TheLexoPlexx/espio/pcb/v2_6/espio.kicad_pcb

## KiCad design pcb/v2_6/espio.kicad_pcb (2025-10-19)

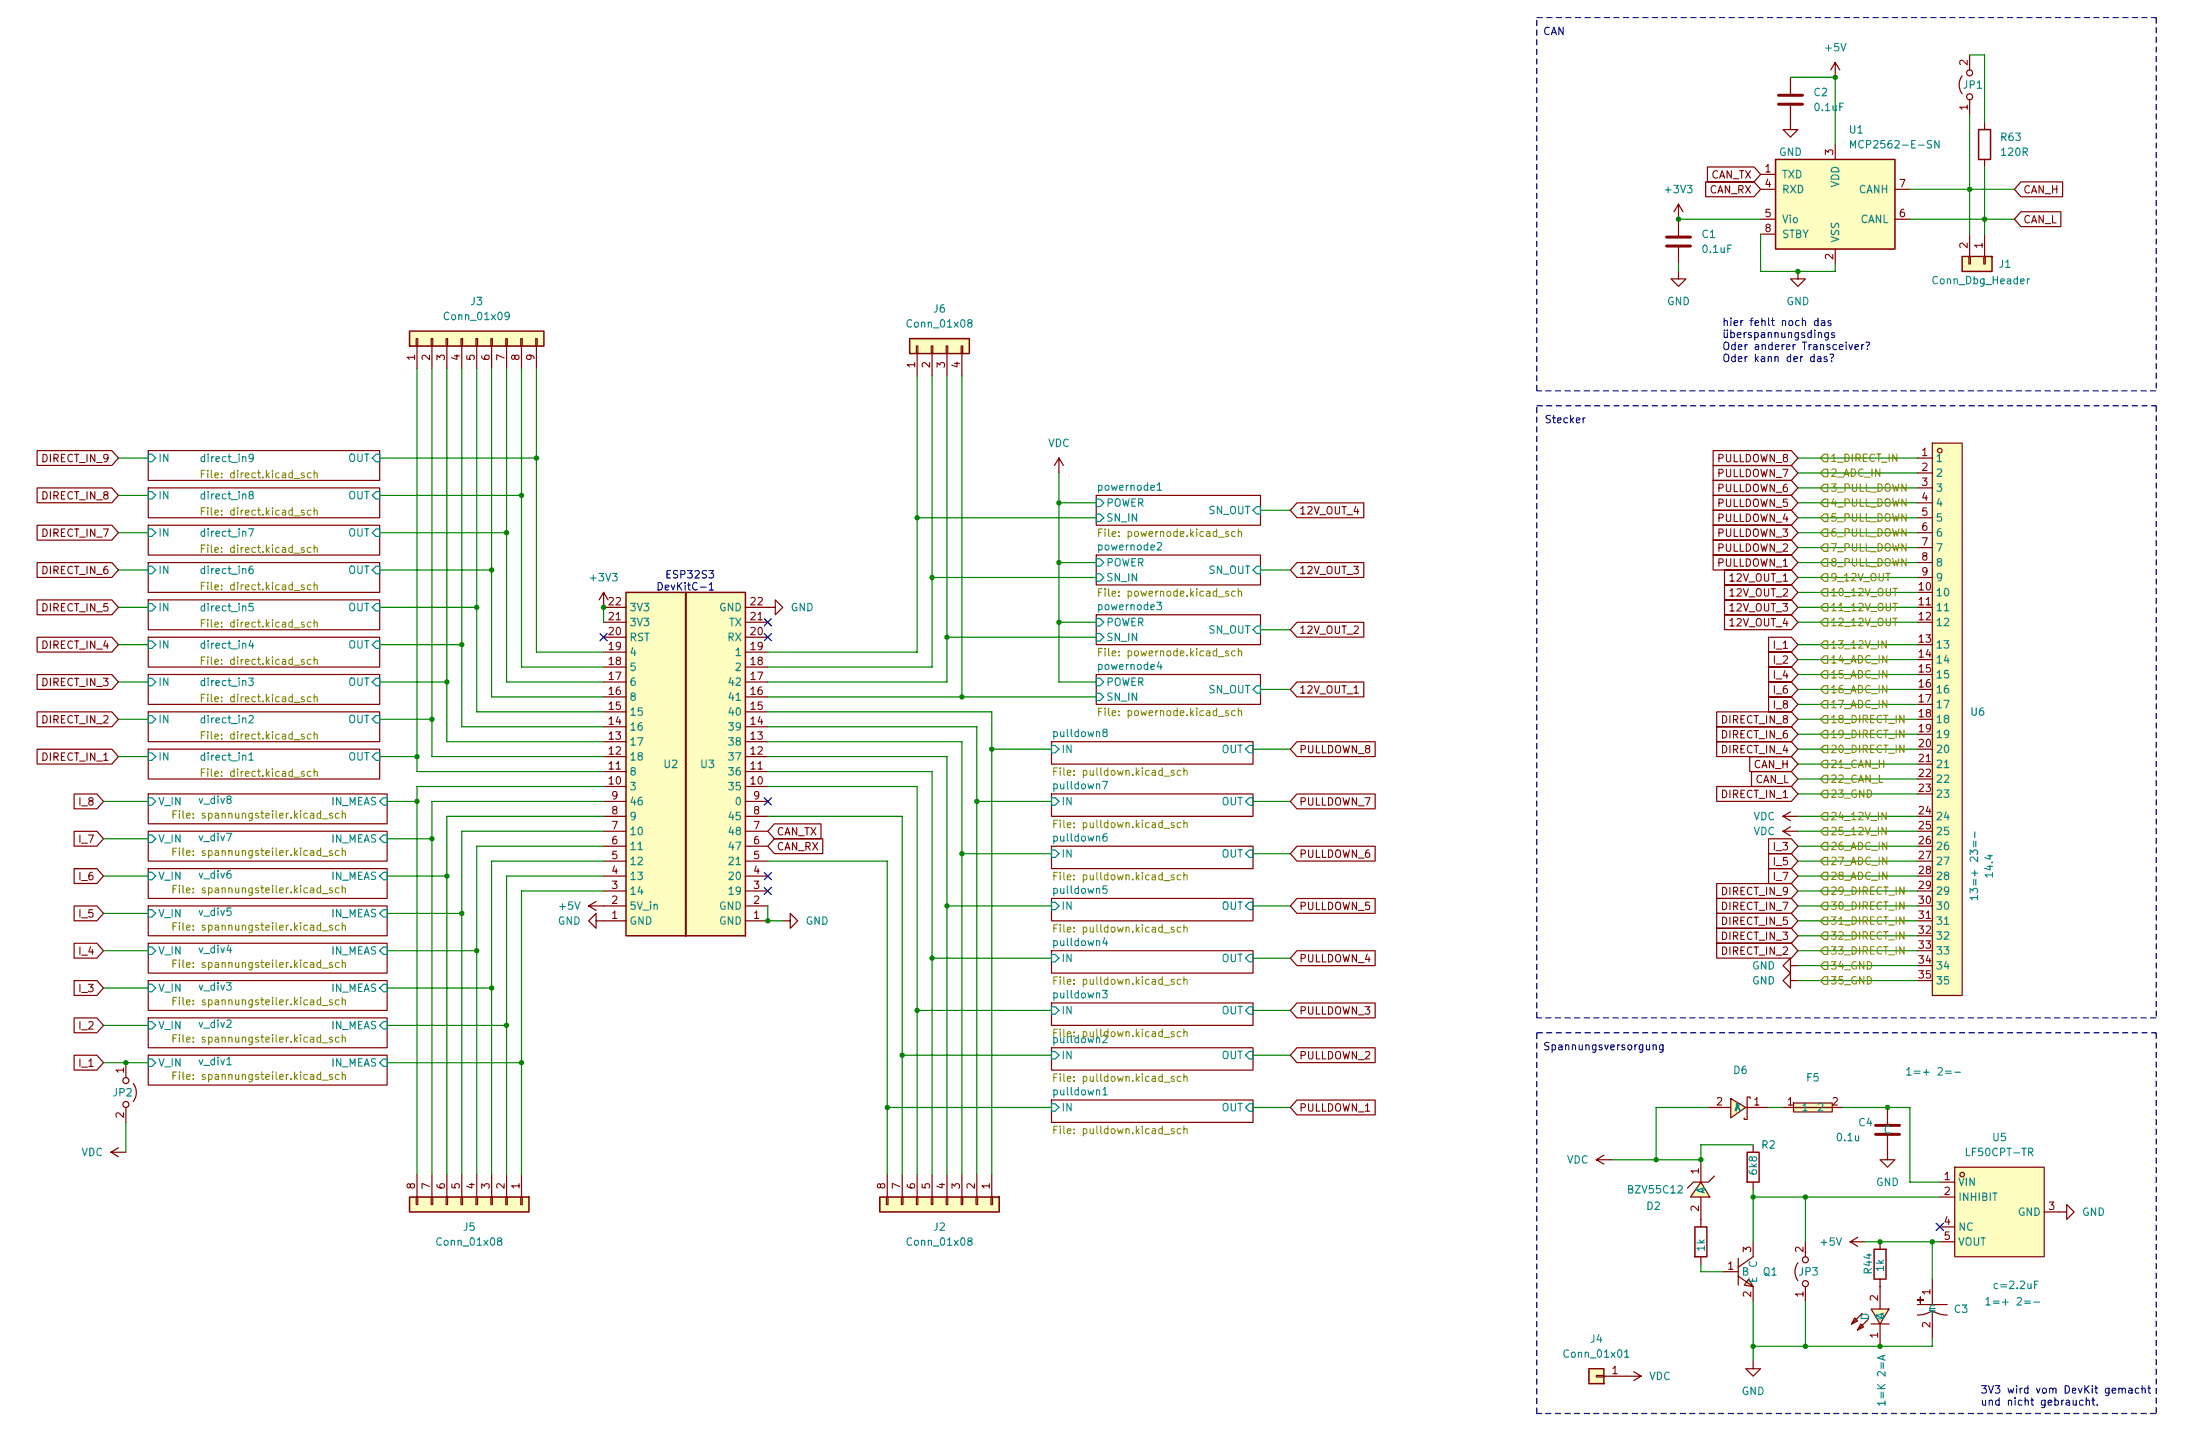
[picture p1: schematic espio.kicad_sch, ESPPDM]

Parts:
C1, C2: 0.1uF; C_0603_1608Metric
C3: c=2.2uF; CAP-SMD_BD6.3-L6.6-W6.6-FD; LCSC Part C335981
C4: 0.1u; C_0603_1608Metric
D2: BZV55C12; SOD-80_L3.5-W1.5-RD; LCSC Part C545360
D6: 1N5819HW-7-F; SOD-123_L2.7-W1.6-LS3.7-RD; LCSC Part C82544
F5: 1812L050/30PR; F1812; LCSC Part C151168
J1: Conn_Dbg_Header; PinHeader_1x02_P2.54mm_Vertical
J2, J5: Conn_01x08; PinHeader_1x08_P2.54mm_Vertical
J3: Conn_01x09; PinHeader_1x09_P2.54mm_Vertical
J4: Conn_01x01; PinHeader_1x01_P2.54mm_Vertical
J6: Conn_01x08; PinHeader_1x04_P2.54mm_Vertical
JP1, JP3: Jumper_2_Open; SolderJumper-2_P1.3mm_Open_Pad1.0x1.5mm
JP2: VCC_as_Pin_8; SolderJumper-2_P1.3mm_Open_Pad1.0x1.5mm
LED1: ${SIM.PARAMS}; LED0603-RD; LCSC Part C193191
Q1: 2SC1623 300-400; SOT-23-3_L2.9-W1.3-P1.90-LS2.4-BR; LCSC Part C2133
R2: 6k8; R_0603_1608Metric
R3, R44: 1k; R_0603_1608Metric
R63: 120R; R_0603_1608Metric
U1: MCP2562-E-SN; SOIC-8_3.9x4.9mm_P1.27mm; lcsc C53609
U2, U3: PinSocket_1x22_P2.54mm_Vertical
U5: LF50CPT-TR; PPAK-5_L6.5-W6.1-P1.27-LS10.0-TL; LCSC Part C2970955
U6: 14.4; CONN-TH_35P-P4.00_K776180WR-2; LCSC Part C2997462

Connections:
12V_OUT_1: U6.9; also elsewhere on the board
12V_OUT_2: U6.10; also elsewhere on the board
12V_OUT_3: U6.11; also elsewhere on the board
12V_OUT_4: U6.12; also elsewhere on the board
+3V3: C1.1, U1.5 (Vio), U2.21 (3V3), U2.22 (3V3)
+5V: C2.1, C3.1, R44.2, U1.3 (VDD), U2.2 (5V_in), U5.5 (VOUT)
/powernode1/SN_IN: J6.1, U3.19 (1); also elsewhere on the board
/powernode2/SN_IN: J6.2, U3.18 (2); also elsewhere on the board
/powernode3/SN_IN: J6.3, U3.17 (42); also elsewhere on the board
/powernode4/SN_IN: J6.4, U3.16 (41); also elsewhere on the board
/pulldown1/IN: J2.8, U3.5 (21); also elsewhere on the board
/pulldown2/IN: J2.7, U3.8 (45); also elsewhere on the board
/pulldown3/IN: J2.6, U3.10 (35); also elsewhere on the board
/pulldown4/IN: J2.5, U3.11 (36); also elsewhere on the board
/pulldown5/IN: J2.4, U3.12 (37); also elsewhere on the board
/pulldown6/IN: J2.3, U3.13 (38); also elsewhere on the board
/pulldown7/IN: J2.2, U3.14 (39); also elsewhere on the board
/pulldown8/IN: J2.1, U3.15 (40); also elsewhere on the board
/v_div1/IN_MEAS: J5.1, U2.3 (14); also elsewhere on the board
/v_div2/IN_MEAS: J5.2, U2.4 (13); also elsewhere on the board
/v_div3/IN_MEAS: J5.3, U2.5 (12); also elsewhere on the board
/v_div4/IN_MEAS: J5.4, U2.6 (11); also elsewhere on the board
/v_div5/IN_MEAS: J5.5, U2.7 (10); also elsewhere on the board
/v_div6/IN_MEAS: J5.6, U2.8 (9); also elsewhere on the board
/v_div7/IN_MEAS: J5.7, U2.9 (46); also elsewhere on the board
/v_div8/IN_MEAS: J5.8, U2.10 (3); also elsewhere on the board
CAN_H: J1.2, JP1.1 (A), U1.7 (CANH), U6.21
CAN_L: J1.1, R63.2, U1.6 (CANL), U6.22
CAN_RX: U1.4 (RXD), U3.6 (47)
CAN_TX: U1.1 (TXD), U3.7 (48)
DIRECT_IN_1: J3.1, U2.11 (8), U6.23; also elsewhere on the board
DIRECT_IN_2: J3.2, U2.12 (18), U6.33; also elsewhere on the board
DIRECT_IN_3: J3.3, U2.13 (17), U6.32; also elsewhere on the board
DIRECT_IN_4: J3.4, U2.14 (16), U6.20; also elsewhere on the board
DIRECT_IN_5: J3.5, U2.15, U6.31; also elsewhere on the board
DIRECT_IN_6: J3.6, U2.16 (8), U6.19; also elsewhere on the board
DIRECT_IN_7: J3.7, U2.17 (6), U6.30; also elsewhere on the board
DIRECT_IN_8: J3.8, U2.18 (5), U6.18; also elsewhere on the board
DIRECT_IN_9: J3.9, U2.19 (4), U6.29; also elsewhere on the board
GND: C1.2, C2.2, C3.2, C4.2, JP3.1 (A), LED1.1 (C), Q1.2 (E), U1.2 (VSS), U1.8 (STBY), U2.1 (GND), U3.1 (GND), U3.2 (GND), U3.22 (GND), U5.3 (GND), U6.34, U6.35; also elsewhere on the board
I_1: JP2.1 (A), U6.13; also elsewhere on the board
I_2: U6.14; also elsewhere on the board
I_3: U6.26; also elsewhere on the board
I_4: U6.15; also elsewhere on the board
I_5: U6.27; also elsewhere on the board
I_6: U6.16; also elsewhere on the board
I_7: U6.28; also elsewhere on the board
I_8: U6.17; also elsewhere on the board
unnamed: D2.2 (A), R3.1
unnamed: D6.1 (K), F5.1
unnamed: JP1.2 (B), R63.1
unnamed: JP3.2 (B), Q1.3 (C), R2.2, U5.2 (INHIBIT)
unnamed: LED1.2 (A), R44.1
unnamed: Q1.1 (B), R3.2
unnamed: C4.1, F5.2, U5.1 (VIN)
PULLDOWN_1: U6.8; also elsewhere on the board
PULLDOWN_2: U6.7; also elsewhere on the board
PULLDOWN_3: U6.6; also elsewhere on the board
PULLDOWN_4: U6.5; also elsewhere on the board
PULLDOWN_5: U6.4; also elsewhere on the board
PULLDOWN_6: U6.3; also elsewhere on the board
PULLDOWN_7: U6.2; also elsewhere on the board
PULLDOWN_8: U6.1; also elsewhere on the board
VDC: D2.1 (C), D6.2 (A), J4.1, JP2.2 (B), R2.1, U6.24, U6.25; also elsewhere on the board

Notes on the sheet:
3V3 wird vom DevKit gemacht und nicht gebraucht.
Stecker
CAN
hier fehlt noch das überspannungsdings Oder anderer Transceiver? Oder kann der das?
Spannungsversorgung
ESP32S3 DevKitC-1

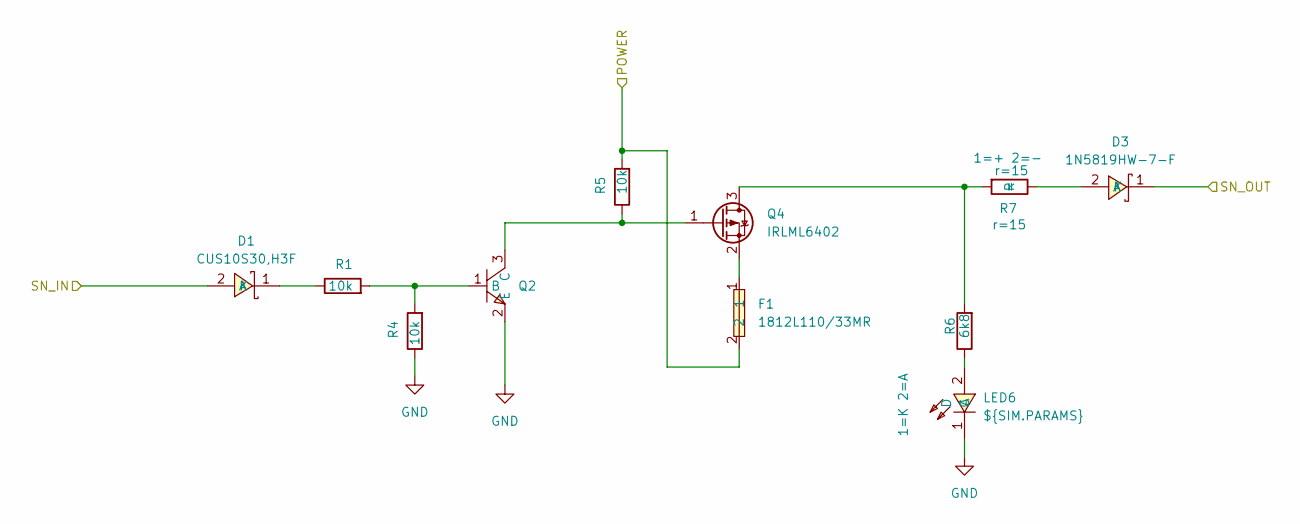
[picture p2: schematic powernode.kicad_sch]

Parts:
D1: CUS10S30,H3F; SOD-323_L1.8-W1.3-LS2.5-RD; LCSC Part C146335
D3: 1N5819HW-7-F; SOD-123_L2.7-W1.6-LS3.7-RD; LCSC Part C82544
F1: 1812L110/33MR; F1812; LCSC Part C142747
LED6: ${SIM.PARAMS}; LED0603-RD; LCSC Part C193191
Q2: 2SC1623 300-400; SOT-23-3_L2.9-W1.3-P1.90-LS2.4-BR; LCSC Part C2133
Q4: IRLML6402; SOT-23
R1, R4, R5: 10k; R_0603_1608Metric
R6: 6k8; R_0603_1608Metric
R7: r=15; R_Axial_DIN0207_L6.3mm_D2.5mm_P7.62mm_Horizontal

Connections:
12V_OUT_4: D3.1 (K); also elsewhere on the board
/powernode1/SN_IN: D1.2 (A); also elsewhere on the board
GND: LED6.1 (C), Q2.2 (E), R4.1; also elsewhere on the board
unnamed: D1.1 (K), R1.1
unnamed: D3.2 (A), R7.1
unnamed: LED6.2 (A), R6.1
unnamed: Q2.1 (B), R1.2, R4.2
unnamed: Q2.3 (C), Q4.1 (G), R5.1
unnamed: Q4.3 (D), R6.2, R7.2
unnamed: F1.1, Q4.2 (S)
VDC: F1.2, R5.2; also elsewhere on the board

Parts of its further copies:
D4, D7, D9: CUS10S30,H3F; SOD-323_L1.8-W1.3-LS2.5-RD; LCSC Part C146335
D5, D8, D10: 1N5819HW-7-F; SOD-123_L2.7-W1.6-LS3.7-RD; LCSC Part C82544
F2, F3, F4: 1812L110/33MR; F1812; LCSC Part C142747
Q6, Q9, Q14: 2SC1623 300-400; SOT-23-3_L2.9-W1.3-P1.90-LS2.4-BR; LCSC Part C2133
Q8, Q11, Q15: IRLML6402; SOT-23
R8, R9, R10, R16, R18, R19, R30, R31, R32: 10k; R_0603_1608Metric
R11, R20, R37: 6k8; R_0603_1608Metric
R13, R29, R38: r=15; R_Axial_DIN0207_L6.3mm_D2.5mm_P7.62mm_Horizontal

Connections of its further copies:
12V_OUT_1: D10.1 (K); also elsewhere on the board
12V_OUT_2: D8.1 (K); also elsewhere on the board
12V_OUT_3: D5.1 (K); also elsewhere on the board
/powernode2/SN_IN: D4.2 (A); also elsewhere on the board
/powernode3/SN_IN: D7.2 (A); also elsewhere on the board
/powernode4/SN_IN: D9.2 (A); also elsewhere on the board
GND: Q6.2 (E), Q9.2 (E), Q14.2 (E), R9.1, R18.1, R31.1; also elsewhere on the board
unnamed: D4.1 (K), R8.1
unnamed: D5.2 (A), R13.1
unnamed: D7.1 (K), R16.1
unnamed: D8.2 (A), R29.1
unnamed: D9.1 (K), R30.1
unnamed: D10.2 (A), R38.1
unnamed 75: R11.1; also elsewhere on the board
unnamed 76: R20.1; also elsewhere on the board
unnamed 77: R37.1; also elsewhere on the board
unnamed: Q6.1 (B), R8.2, R9.2
unnamed: Q6.3 (C), Q8.1 (G), R10.1
unnamed: Q8.3 (D), R11.2, R13.2
unnamed: F2.1, Q8.2 (S)
unnamed: Q9.1 (B), R16.2, R18.2
unnamed: Q11.3 (D), R20.2, R29.2
unnamed: Q9.3 (C), Q11.1 (G), R19.1
unnamed: F3.1, Q11.2 (S)
unnamed: Q14.1 (B), R30.2, R31.2
unnamed: Q14.3 (C), Q15.1 (G), R32.1
unnamed: Q15.3 (D), R37.2, R38.2
unnamed: F4.1, Q15.2 (S)
VDC: F2.2, F3.2, F4.2, R10.2, R19.2, R32.2; also elsewhere on the board

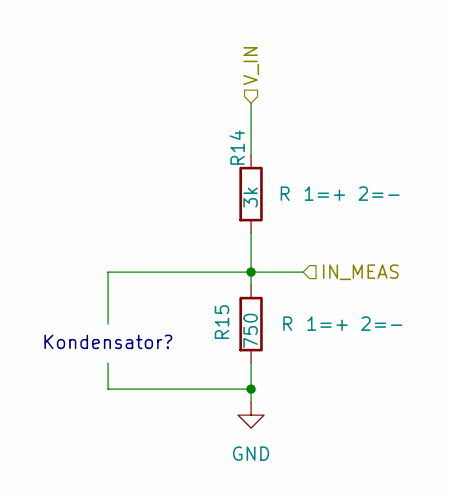
[picture p3: schematic spannungsteiler.kicad_sch]

Parts:
R14: 3k; R_0603_1608Metric
R15: 750; R_0603_1608Metric

Connections:
/v_div1/IN_MEAS: R14.2, R15.1; also elsewhere on the board
GND: R15.2; also elsewhere on the board
I_1: R14.1; also elsewhere on the board

Parts of its further copies:
R12, R21, R23, R25, R27, R33, R35: 3k; R_0603_1608Metric
R17, R22, R24, R26, R28, R34, R36: 750; R_0603_1608Metric

Connections of its further copies:
/v_div2/IN_MEAS: R12.2, R17.1; also elsewhere on the board
/v_div3/IN_MEAS: R21.2, R22.1; also elsewhere on the board
/v_div4/IN_MEAS: R23.2, R24.1; also elsewhere on the board
/v_div5/IN_MEAS: R25.2, R26.1; also elsewhere on the board
/v_div6/IN_MEAS: R27.2, R28.1; also elsewhere on the board
/v_div7/IN_MEAS: R33.2, R34.1; also elsewhere on the board
/v_div8/IN_MEAS: R35.2, R36.1; also elsewhere on the board
GND: R17.2, R22.2, R24.2, R26.2, R28.2, R34.2, R36.2; also elsewhere on the board
I_2: R12.1; also elsewhere on the board
I_3: R21.1; also elsewhere on the board
I_4: R23.1; also elsewhere on the board
I_5: R25.1; also elsewhere on the board
I_6: R27.1; also elsewhere on the board
I_7: R33.1; also elsewhere on the board
I_8: R35.1; also elsewhere on the board

Notes on the sheet:
Kondensator?

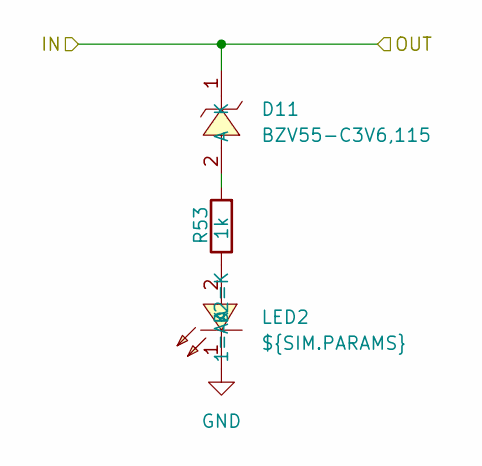
[picture p4: schematic direct.kicad_sch]

Parts:
D11: BZV55-C3V6,115; LL-34_L3.5-W1.5-RD; LCSC Part C513232
LED2: ${SIM.PARAMS}; LED0603-RD; LCSC Part C205445
R53: 1k; R_0603_1608Metric

Connections:
DIRECT_IN_1: D11.1 (K); also elsewhere on the board
GND: LED2.1 (K); also elsewhere on the board
unnamed: D11.2 (A), R53.2
unnamed: LED2.2 (A), R53.1

Parts of its further copies:
D12, D13, D14, D15, D16, D17, D18, D19: BZV55-C3V6,115; LL-34_L3.5-W1.5-RD; LCSC Part C513232
R54, R55, R56, R57, R58, R59, R60, R61: 1k; R_0603_1608Metric

Connections of its further copies:
DIRECT_IN_2: D12.1 (K); also elsewhere on the board
DIRECT_IN_3: D13.1 (K); also elsewhere on the board
DIRECT_IN_4: D14.1 (K); also elsewhere on the board
DIRECT_IN_5: D15.1 (K); also elsewhere on the board
DIRECT_IN_6: D16.1 (K); also elsewhere on the board
DIRECT_IN_7: D17.1 (K); also elsewhere on the board
DIRECT_IN_8: D18.1 (K); also elsewhere on the board
DIRECT_IN_9: D19.1 (K); also elsewhere on the board
unnamed: D12.2 (A), R54.2
unnamed: D13.2 (A), R55.2
unnamed: D14.2 (A), R56.2
unnamed: D15.2 (A), R57.2
unnamed: D16.2 (A), R58.2
unnamed: D17.2 (A), R59.2
unnamed: D18.2 (A), R60.2
unnamed: D19.2 (A), R61.2
unnamed 71: R54.1; also elsewhere on the board
unnamed 72: R55.1; also elsewhere on the board
unnamed 73: R56.1; also elsewhere on the board
unnamed 78: R57.1; also elsewhere on the board
unnamed 79: R58.1; also elsewhere on the board
unnamed 80: R59.1; also elsewhere on the board
unnamed 81: R60.1; also elsewhere on the board
unnamed 82: R61.1; also elsewhere on the board

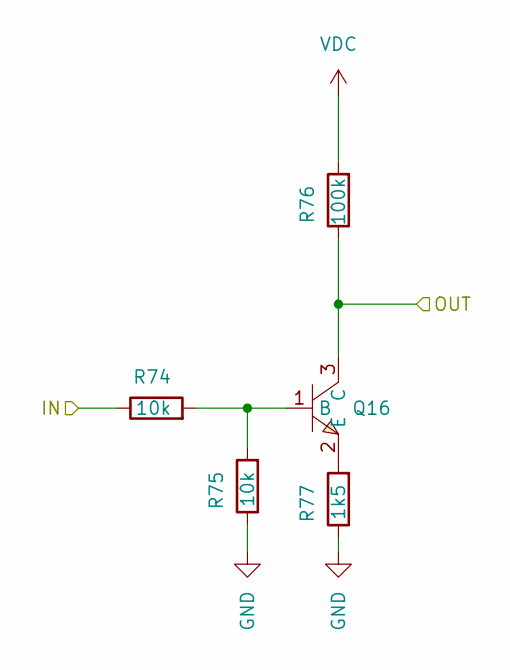
[picture p5: schematic pulldown.kicad_sch]

Parts:
Q16: 2SC1623 300-400; SOT-23-3_L2.9-W1.3-P1.90-LS2.4-BR; LCSC Part C2133
R74, R75: 10k; R_0603_1608Metric
R76: 100k; R_0603_1608Metric
R77: 1k5; R_0603_1608Metric

Connections:
/pulldown7/IN: R74.1; also elsewhere on the board
GND: R75.1, R77.1; also elsewhere on the board
unnamed: Q16.1 (B), R74.2, R75.2
unnamed: Q16.2 (E), R77.2
PULLDOWN_7: Q16.3 (C), R76.1; also elsewhere on the board
VDC: R76.2; also elsewhere on the board

Parts of its further copies:
Q3, Q5, Q7, Q10, Q12, Q13, Q17: 2SC1623 300-400; SOT-23-3_L2.9-W1.3-P1.90-LS2.4-BR; LCSC Part C2133
R39, R42, R45, R48, R49, R51, R80: 100k; R_0603_1608Metric
R40, R43, R46, R47, R50, R62, R66, R69, R70, R71, R72, R73, R78, R79: 10k; R_0603_1608Metric
R41, R52, R64, R65, R67, R68, R81: 1k5; R_0603_1608Metric

Connections of its further copies:
/pulldown1/IN: R46.1; also elsewhere on the board
/pulldown2/IN: R69.1; also elsewhere on the board
/pulldown3/IN: R70.1; also elsewhere on the board
/pulldown4/IN: R71.1; also elsewhere on the board
/pulldown5/IN: R72.1; also elsewhere on the board
/pulldown6/IN: R73.1; also elsewhere on the board
/pulldown8/IN: R78.1; also elsewhere on the board
GND: R40.1, R41.1, R43.1, R47.1, R50.1, R52.1, R62.1, R64.1, R65.1, R66.1, R67.1, R68.1, R79.1, R81.1; also elsewhere on the board
unnamed: Q3.1 (B), R40.2, R46.2
unnamed: Q3.2 (E), R41.2
unnamed: Q5.1 (B), R43.2, R69.2
unnamed: Q5.2 (E), R52.2
unnamed: Q7.1 (B), R47.2, R70.2
unnamed: Q7.2 (E), R64.2
unnamed: Q10.1 (B), R50.2, R71.2
unnamed: Q10.2 (E), R65.2
unnamed: Q12.1 (B), R62.2, R72.2
unnamed: Q12.2 (E), R67.2
unnamed: Q13.1 (B), R66.2, R73.2
unnamed: Q13.2 (E), R68.2
unnamed: Q17.1 (B), R78.2, R79.2
unnamed: Q17.2 (E), R81.2
PULLDOWN_1: Q3.3 (C), R39.1; also elsewhere on the board
PULLDOWN_2: Q5.3 (C), R42.1; also elsewhere on the board
PULLDOWN_3: Q7.3 (C), R45.1; also elsewhere on the board
PULLDOWN_4: Q10.3 (C), R48.1; also elsewhere on the board
PULLDOWN_5: Q12.3 (C), R49.1; also elsewhere on the board
PULLDOWN_6: Q13.3 (C), R51.1; also elsewhere on the board
PULLDOWN_8: Q17.3 (C), R80.1; also elsewhere on the board
VDC: R39.2, R42.2, R45.2, R48.2, R49.2, R51.2, R80.2; also elsewhere on the board

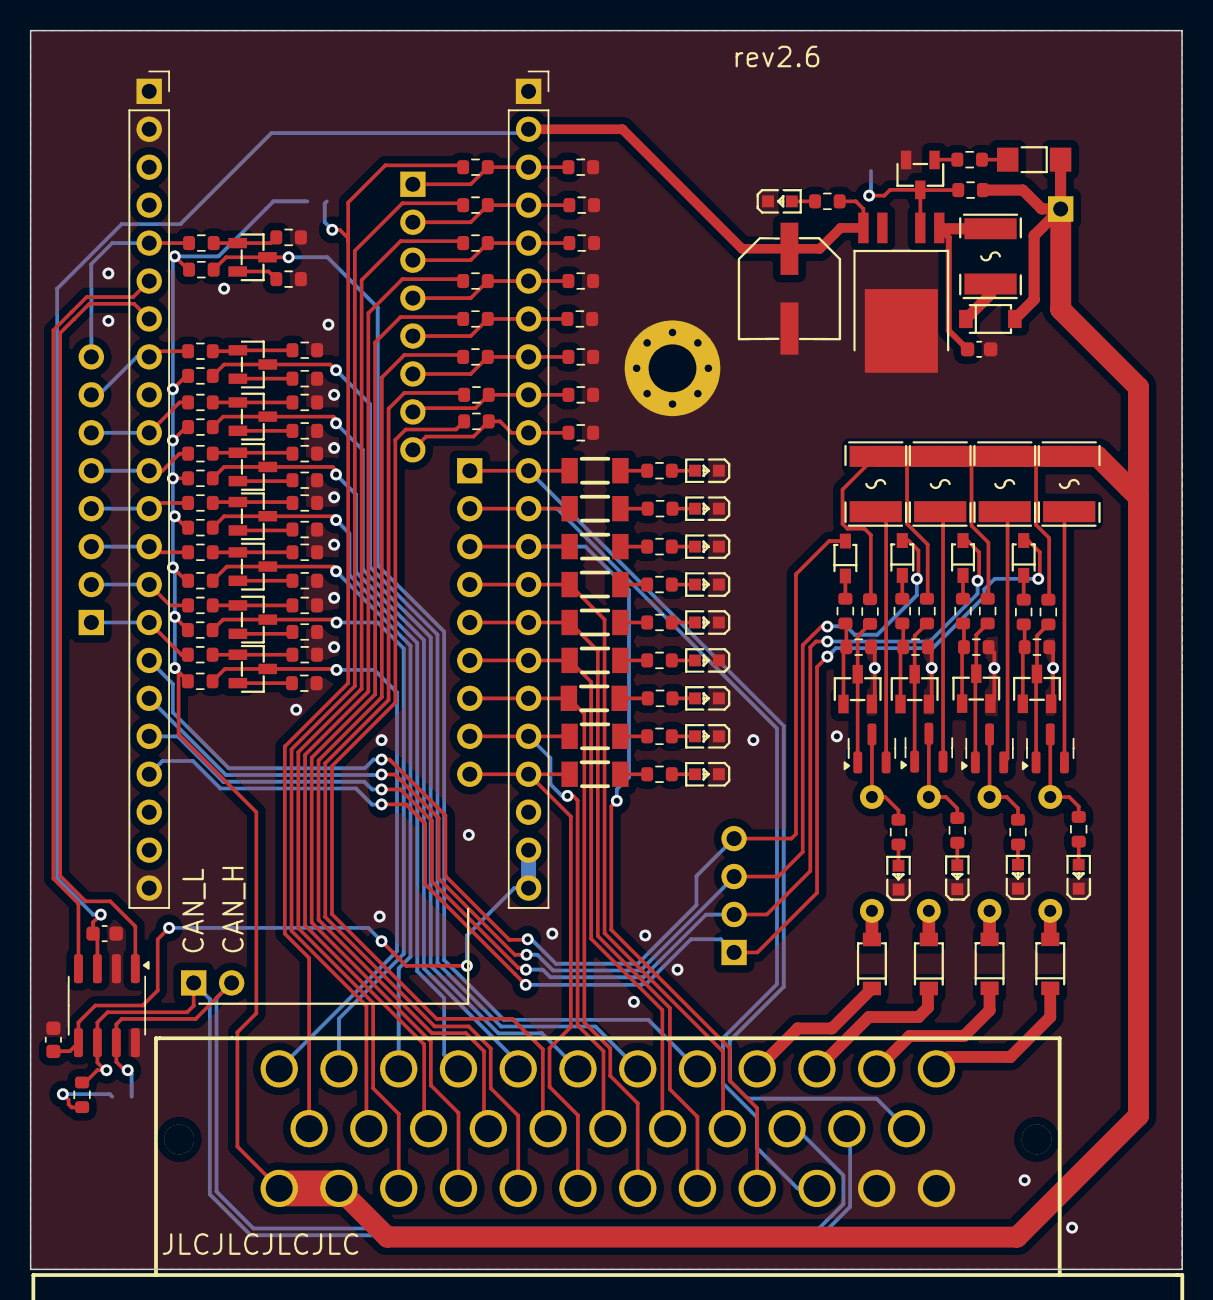
[picture p6: board pcb/v2_6/espio.kicad_pcb from above]

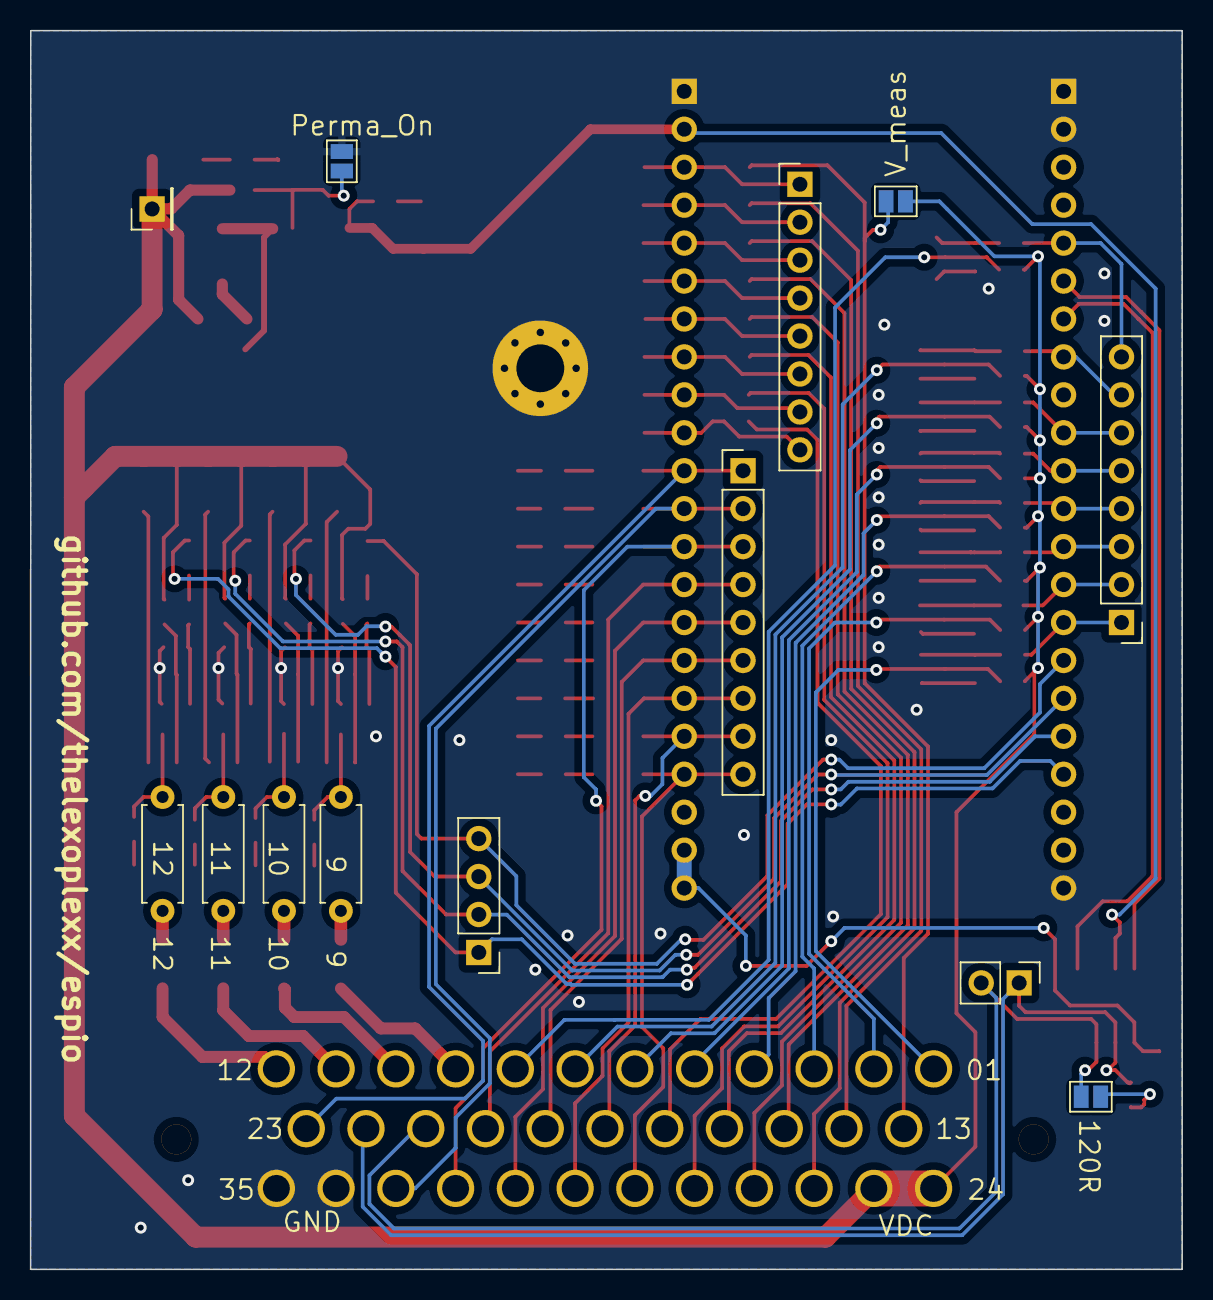
[picture p7: board pcb/v2_6/espio.kicad_pcb from below]

Board: 2 copper layers, 77.1 x 82.9 mm, 154 parts (13 on the bottom side), 126 nets.

Other parts of the board:
LED3, LED4, LED5, LED7, LED8, LED9, LED10, LED11, LED12, LED13, LED14: LED0603-RD

Their connections:
GND: LED3.1 (K), LED4.1 (K), LED5.1 (K), LED7.1 (C), LED8.1 (C), LED9.1 (C), LED10.1 (K), LED11.1 (K), LED12.1 (K), LED13.1 (K), LED14.1 (K); also elsewhere on the board
unnamed 71: LED3.2 (A); also elsewhere on the board
unnamed 72: LED4.2 (A); also elsewhere on the board
unnamed 73: LED5.2 (A); also elsewhere on the board
unnamed 75: LED7.2 (A); also elsewhere on the board
unnamed 76: LED8.2 (A); also elsewhere on the board
unnamed 77: LED9.2 (A); also elsewhere on the board
unnamed 78: LED10.2 (A); also elsewhere on the board
unnamed 79: LED11.2 (A); also elsewhere on the board
unnamed 80: LED12.2 (A); also elsewhere on the board
unnamed 81: LED13.2 (A); also elsewhere on the board
unnamed 82: LED14.2 (A); also elsewhere on the board
