TheLexoPlexx/espio/pcb/v2_5/espio_v2_5.kicad_pcb

## KiCad design pcb/v2_5/espio_v2_5.kicad_pcb (2025-08-19, an earlier design)

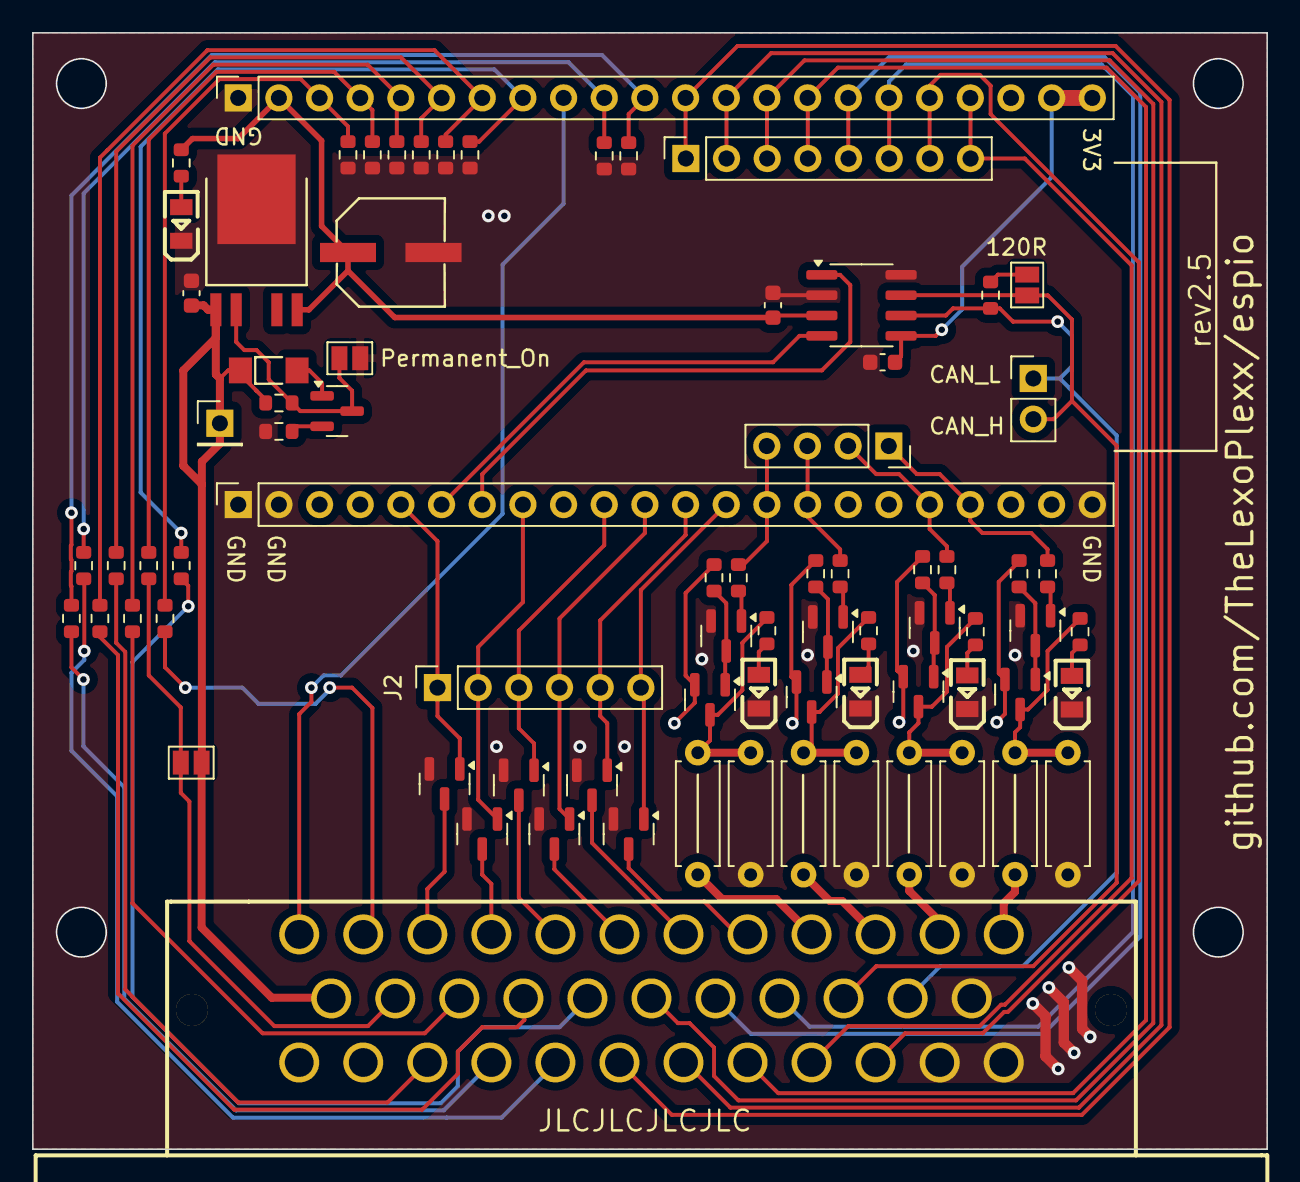
[picture p8: board espio_v2_5.kicad_pcb from above]

Board: 2 copper layers, 77.1 x 69.7 mm, 78 parts (0 on the bottom side), 74 nets.

Parts:
C1, C2, C4: 0.1uF; C_0603_1608Metric
C3: RVT2A2R2M0605_C335981; CAP-SMD_BD6.3-L6.6-W6.6-FD
D2: BZV55C15_C545332; SOD-80_L3.5-W1.5-RD
J1: Conn_Dbg_Header; PinHeader_1x02_P2.54mm_Vertical
J2: Conn_01x07; PinSocket_1x06_P2.54mm_Vertical
J3: Conn_01x08; PinSocket_1x08_P2.54mm_Vertical
J4: Conn_01x01; PinHeader_1x01_P2.54mm_Vertical
J6: Conn_01x08; PinSocket_1x04_P2.54mm_Vertical
JP1, JP3: Jumper_2_Open; SolderJumper-2_P1.3mm_Open_Pad1.0x1.5mm
JP2: VCC_as_Pin_8; SolderJumper-2_P1.3mm_Open_Pad1.0x1.5mm
LED1, LED2, LED3, LED4, LED5: 0805G (Green); LED0805-R-RD
Q1, Q3, Q5, Q7, Q9, Q10, Q11, Q12, Q13, Q15, Q16: BC817; SOT-23
Q2, Q4, Q6, Q8: IRLML6402; SOT-23
R1, R3, R18, R19, R20: 1k; R_0603_1608Metric
R2: 4k; R_0603_1608Metric
R4, R5, R6, R7, R8, R9, R10, R11: DNP; R_Axial_DIN0207_L6.3mm_D2.5mm_P7.62mm_Horizontal
R12, R14, R21, R23, R25, R27, R33, R35: 3k; R_0603_1608Metric
R13, R16, R37, R38: 2k4; R_0603_1608Metric
R15, R17, R22, R24, R26, R28, R34, R36: 750R; R_0603_1608Metric
R29, R30, R31, R32: 10k; R_0603_1608Metric
R39: 470; R_0603_1608Metric
R63: 120R; R_0603_1608Metric
U1: MCP2562-E-SN; SOIC-8_3.9x4.9mm_P1.27mm
U2, U3: PinSocket_1x22_P2.54mm_Vertical
U5: LF50CPT-TR; PPAK-5_L6.5-W6.1-P1.27-LS10.0-TL
U6: K776180WR-1; CONN-TH_35P-P4.00_K776180WR-2

Connections:
+3V3: C1.1, U1.5 (Vio), U2.21 (3V3), U2.22 (3V3)
+5V: C2.1, C3.1, R39.1, U1.3 (VDD), U2.2 (5V_in), U5.5 (VOUT)
+12V: C4.1, D2.1 (C), J4.1, JP2.1 (A), Q2.2 (S), Q4.2 (S), Q6.2 (S), Q8.2 (S), R2.1, R29.2, R30.2, R31.2, R32.2, U5.1 (VIN), U6.13, U6.24, U6.25
/3_PULL_DOWN: Q13.3 (C), U6.3
/4_PULL_DOWN: Q12.3 (C), U6.4
/5_PULL_DOWN: Q15.3 (C), U6.5
/6_PULL_DOWN: Q10.3 (C), U6.6
/7_PULL_DOWN: Q9.3 (C), U6.7
/8_PULL_DOWN: Q11.3 (C), U6.8
/9_12V_OUT: R11.1, U6.9
/10_12V_OUT: R10.1, U6.10
/11_12V_OUT: R9.1, U6.11
/12_12V_OUT: R8.1, U6.12
/Spannungsteiler1/IN_MEAS: R21.2, R22.1, U2.4 (13)
/Spannungsteiler2/IN_MEAS: R12.2, R17.1, U2.6 (11)
/Spannungsteiler3/IN_MEAS: R23.2, R24.1, U2.5 (12)
/Spannungsteiler4/IN_MEAS: R25.2, R26.1, U2.7 (10)
/Spannungsteiler5/IN_MEAS: R27.2, R28.1, U2.8 (9)
/Spannungsteiler6/IN_MEAS: R33.2, R34.1, U2.11 (8)
/Spannungsteiler7/IN_MEAS: R35.2, R36.1, U2.10 (3)
/Spannungsteiler8/IN_MEAS: R14.2, R15.1, U2.3 (14)
/SwitchingNode1/SN_IN: J6.1, R1.1, U3.19 (1)
/SwitchingNode2/SN_IN: J6.2, R18.1, U3.18 (2)
/SwitchingNode3/SN_IN: J6.3, R19.1, U3.15 (40)
/SwitchingNode4/SN_IN: J6.4, R20.1, U3.14 (39)
ABS_INPUT_HL_1: J3.5, U2.16 (8), U6.19
ABS_INPUT_HL_2: J3.3, U2.14 (16), U6.18
ABS_INPUT_HR_1: J3.2, U2.13 (17), U6.30
ABS_INPUT_HR_2: J3.1, U2.12 (18), U6.29
ABS_INPUT_VL_1: J3.8, U2.19 (4), U6.32
ABS_INPUT_VL_2: J3.7, U2.18 (5), U6.33
ABS_INPUT_VR_1: J3.6, U2.17 (6), U6.20
ABS_INPUT_VR_2: J3.4, U2.15, U6.31
CAN_H: J1.2, JP1.1 (A), U1.7 (CANH), U6.21
CAN_L: J1.1, R63.2, U1.6 (CANL), U6.22
CAN_RX: U1.4 (RXD), U3.6 (47)
CAN_TX: U1.1 (TXD), U3.7 (48)
GND: C1.2, C2.2, C3.2, C4.2, JP3.1 (A), LED1.2 (K), LED2.2 (K), LED3.2 (K), LED4.2 (K), LED5.2 (K), Q1.2 (E), Q3.2 (E), Q5.2 (E), Q7.2 (E), Q9.2 (E), Q10.2 (E), Q11.2 (E), Q12.2 (E), Q13.2 (E), Q15.2 (E), R3.2, R4.1, R5.1, R6.1, R7.1, R15.2, R17.2, R22.2, R24.2, R26.2, R28.2, R34.2, R36.2, U1.2 (VSS), U1.8 (STBY), U2.1 (GND), U3.1 (GND), U3.2 (GND), U3.22 (GND), U5.3 (GND), U6.23, U6.34, U6.35
I_1: JP2.2 (B), R21.1, U6.14
I_2: R23.1, U6.15
I_3: R25.1, U6.16
I_4: R27.1, U6.17
I_6: R14.1, U6.2
I_8: R12.1, U6.26
I_9: R33.1, U6.27
I_10: R35.1, U6.28
unnamed: D2.2 (A), Q16.1 (B)
unnamed: J2.1, Q13.1 (B), U3.5 (21)
unnamed: J2.2, Q12.1 (B), U3.8 (45)
unnamed: J2.3, Q15.1 (B), U3.10 (35)
unnamed: J2.4, Q10.1 (B), U3.11 (36)
unnamed: J2.5, Q9.1 (B), U3.12 (37)
unnamed: J2.6, Q11.1 (B), U3.13 (38)
unnamed: JP1.2 (B), R63.1
unnamed: JP3.2 (B), Q16.3 (C), R2.2, U5.2 (INHIBIT)
unnamed: LED1.1 (A), R13.1
unnamed: LED2.1 (A), R16.1
unnamed: LED3.1 (A), R37.1
unnamed: LED4.1 (A), R38.1
unnamed: LED5.1 (A), R39.2
unnamed: Q1.1 (B), R1.2
unnamed: Q1.3 (C), Q2.1 (G), R29.1
unnamed: Q2.3 (D), R4.2, R8.2, R13.2
unnamed: Q3.1 (B), R18.2
unnamed: Q3.3 (C), Q4.1 (G), R30.1
unnamed: Q4.3 (D), R5.2, R9.2, R16.2
unnamed: Q5.1 (B), R19.2
unnamed: Q5.3 (C), Q6.1 (G), R31.1
unnamed: Q6.3 (D), R6.2, R10.2, R37.2
unnamed: Q7.1 (B), R20.2
unnamed: Q7.3 (C), Q8.1 (G), R32.1
unnamed: Q8.3 (D), R7.2, R11.2, R38.2
unnamed: Q16.2 (E), R3.1
OUT_1: U2.9 (46), U6.1
