TheLexoPlexx/espio/pcb/espio.kicad_pcb

## KiCad design pcb/espio.kicad_pcb (2025-08-18)

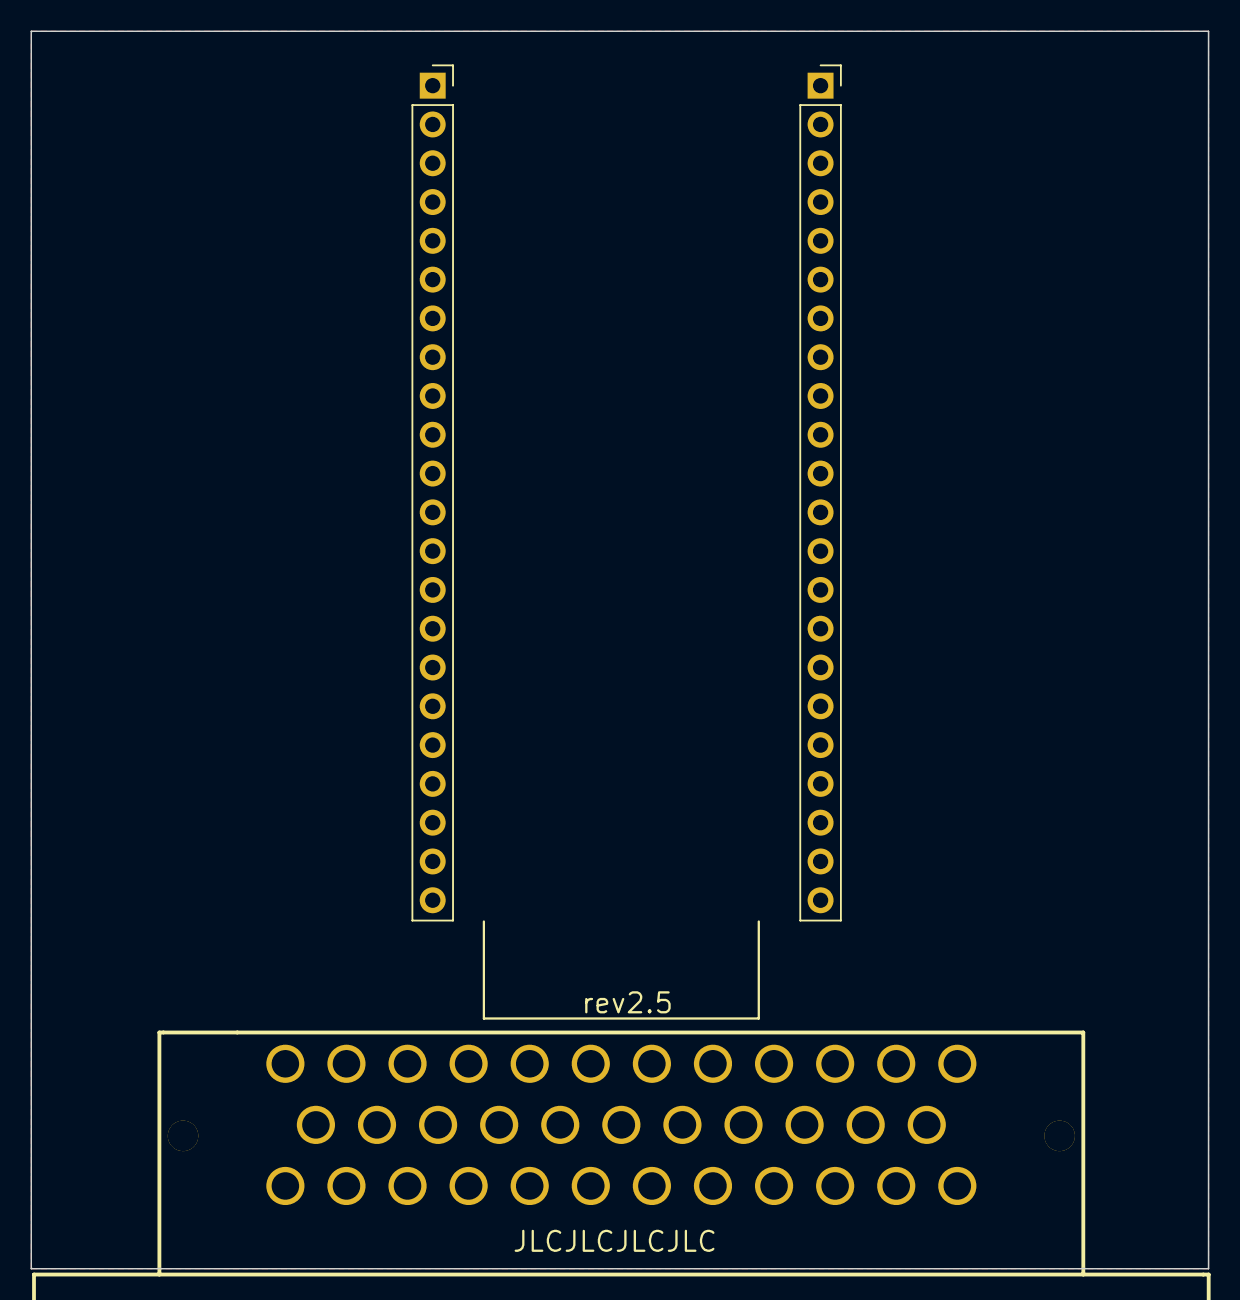
[picture p9: board pcb/espio.kicad_pcb from above]

Board: 2 copper layers, 77.1 x 81.0 mm, 3 parts (0 on the bottom side), 12 nets, no tracks yet.

Parts:
U2, U3: PinSocket_1x22_P2.54mm_Vertical
U6: K776180WR-1; CONN-TH_35P-P4.00_K776180WR-2

Connections:
+3V3: U2.21 (3V3), U2.22 (3V3)
+12V: U6.13, U6.24, U6.25
DIRECT_IN_1: U2.11 (8), U6.1
DIRECT_IN_2: U2.12 (18), U6.33
DIRECT_IN_3: U2.13 (17), U6.32
DIRECT_IN_4: U2.14 (16), U6.31
DIRECT_IN_5: U2.15, U6.30
DIRECT_IN_6: U2.16 (8), U6.29
DIRECT_IN_7: U2.17 (6), U6.20
DIRECT_IN_8: U2.18 (5), U6.19
DIRECT_IN_9: U2.19 (4), U6.18
GND: U2.1 (GND), U3.1 (GND), U3.2 (GND), U3.22 (GND), U6.23, U6.34, U6.35
