TheLexoPlexx/espio/(commit log)

2025-06-23 some stuff
    [espio.kicad_sch, partitions.csv]
2025-06-28 Add counters to ebu, update schematic
    [espio_engine_bay_unit.kicad_sch]
2025-07-04 safety commit
    [engine_bay_unit.kicad_sch, espio.kicad_pcb, espio.kicad_sch, espio_engine_bay_unit.kicad_sch, kombiinstrument.kicad_sch, switchnode.kicad_sch]
2025-07-06 up to date
    [bom.csv, designators.csv, engine_bay_unit.kicad_sch, espio.kicad_pcb, espio.kicad_sch, espio_alt_jumpers.kicad_sch, kombiinstrument.kicad_sch, positions.csv]
2025-07-20 edited a lot
    [espio.kicad_pcb, espio.kicad_sch, partitions.csv]
2025-07-23 Final stretch, maybe
    [espio.kicad_sch]
2025-07-24 Edit schematic
2025-07-26 Fixed brake pedal status pin
    [kombiinstrument.rs]
2025-07-27 Refactor dev_can_sender and fix some things
    [engine_bay_unit.rs, kombiinstrument.rs, util.rs]
2025-07-27 Fixed lots of stuff but refactoring is desperatly needed
    [engine_bay_unit.rs, kombiinstrument.rs, main.rs]
2025-07-27 Brake pedal does not work as expected when ignition is on
    [engine_bay_unit.rs, kombiinstrument.rs, util.rs]
2025-07-29 pin fixes
    [engine_bay_unit.kicad_sch, espio.kicad_pcb, espio.kicad_sch, espio_alt_jumpers.kicad_sch, kombiinstrument.kicad_sch, switchnode.kicad_sch]
2025-07-29 pcb v3
    [bom.csv, designators.csv, espio_rev3.kicad_pcb, espio_rev3.kicad_sch, positions.csv, switchnode.kicad_sch]
2025-08-02 Huge refactor (by Gemini) to only use two threads. - one for can receive - one for the main app logic Doesn't need AppState anymore. Added filter to can-config.
    [engine_bay_unit.rs, kombiinstrument.rs]
2025-08-15 Added ESPIO struct and ESPIO pins, but not sure if I like it.
    [espio.kicad_sch, spannungsteiler.kicad_sch]
2025-08-16 rgb_led_fix 1
    [espio.kicad_sch]
2025-08-16 Seemingly fixed the LED issue.
    [engine_bay_unit.rs, main.rs]
2025-08-16 recovered lost pcb
    [espio.kicad_pcb, espio.kicad_sch, switchnode.kicad_sch]
2025-08-16 fixed the dumb schematic
    [espio.kicad_sch, spannungsteiler.kicad_sch, switchnode.kicad_sch]
2025-08-16 learned from my mistakes
    [espio.kicad_pcb, espio.kicad_sch, pulldown.kicad_sch, switchnode.kicad_sch]
2025-08-17 added some diodes, fuses etc
    [espio.kicad_pcb, espio.kicad_sch, pulldown.kicad_sch, spannungsteiler.kicad_sch, switchnode.kicad_sch]
2025-08-18 major work
    [espio.kicad_pcb, espio.kicad_sch, pulldown.kicad_sch, spannungsteiler.kicad_sch, switchnode.kicad_sch]
2025-08-18 added missing pieces
    [direct.kicad_sch, powernode.kicad_sch]
2025-08-19 edit pulldown
    [direct.kicad_sch, espio.kicad_pcb, espio.kicad_sch, espio_v2_5.kicad_pcb, espio_v2_5.kicad_sch, powernode.kicad_sch, pulldown.kicad_sch, spannungsteiler.kicad_sch]
2025-10-19 Engine_bay_unit turns on external LED for whatever reason
2025-10-19 Refactor, fix external LED conflict
    [bom.csv, designators.csv, direct.kicad_sch, espio.kicad_pcb, espio.kicad_sch, espio_rev3.kicad_pcb, espio_rev3.kicad_sch, positions.csv]
